mapmot/most-delta/doc/40t-5-bore.jpg

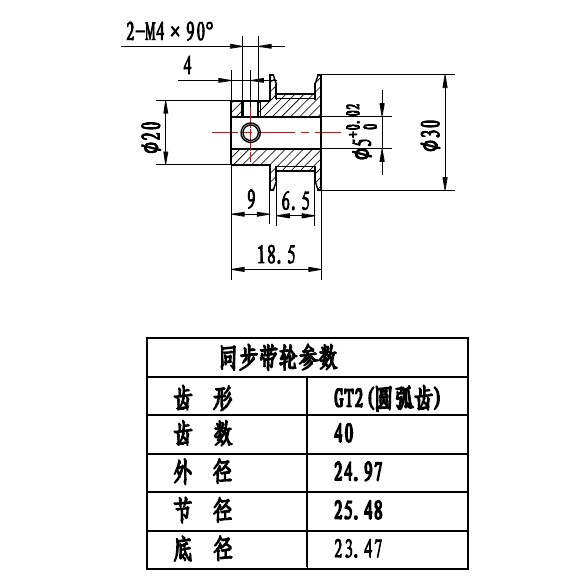
doc/40t-5-bore.jpg
