mapmot/most-delta/doc/mxl-36t-5mm.jpg

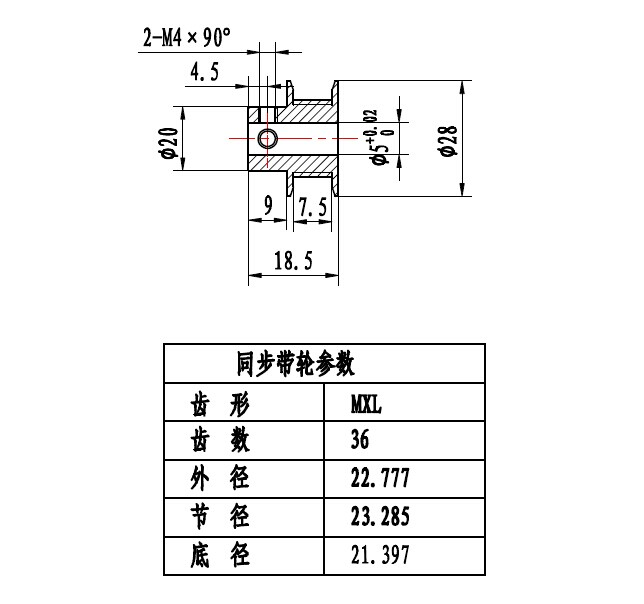
doc/mxl-36t-5mm.jpg
