mapmot/most-delta/MOST_Delta_BOM.ods

Sheet: BOM
Magnetic ball joint version
Part description | Print/Vitamin | Material | UOM | Count | Units | Total units | Functional Unit | Function
608zz bearing | Vitamin | bearing | ea | 6 |  | 6 | Apex | idler bearing
608zz bearing | Vitamin | bearing | ea | 1 |  | 1 | Extruder drive
LM8UU bearing | Vitamin | bearing | ea | 6 |  | 6 | Apex | carriage linear bearing
MR105zz 5mm x 10mm x 4mm bearing | Vitamin | bearing | ea | 1 |  | 1 | Extruder drive
3/8” od ring magnets | Vitamin | magnet | ea | 12 |  | 12 | Tie rod | tie rod ends
T5 timing belt | Vitamin | belting | mm | 3 | 1350 | 4050 | Apex | timing belt
0.25” OD x 0.222” ID Al tubing | Vitamin | Al tube | mm | 6 | 242 | 1452 | Tie rod | Tie rod
3/8” G25 ball bearings | Vitamin | magnet | mm | 12 | 20 | 240 | Tie rod | tie rod pivot
16-Gauge 2 Conductor | Vitamin | conductor | m | 1 |  | 1 | End effector | hot end power
1m twisted pair | Vitamin | conductor | m | 3 | 1 | 3 | Apex | limit switch twisted pair
1m twisted pair | Vitamin | conductor | m | 2 |  | 2 | End effector | fan power and hot end thermistor
8mm diameter drill rod | Vitamin | drill rod | mm | 6 | 595 | 3570 | Apex | guide rod
12V 5A power supply | Vitamin | electronics | ea | 1 |  | 1 | Electronics
40mm x 40mm 12v fan | Vitamin | electronics | ea | 1 |  | 1 | End effector | active cooling
Limit switch | Vitamin | electronics | ea | 3 |  | 3 | Apex | Limit switch
Melzi controller board | Vitamin | electronics | ea | 1 |  | 1 | Electronics
#6 x 3/4” sheet metal screw | Vitamin | fastener | ea | 12 |  | 12 | Apex | motor end base plate mount
#6 x 3/4” sheet metal screw | Vitamin | fastener | ea | 18 |  | 18 | Apex | motor end linking board mount
#6 x 3/4” sheet metal screw | Vitamin | fastener | ea | 12 |  | 12 | Apex | idler end base plate mount
#6 x 3/4” sheet metal screw | Vitamin | fastener | ea | 18 |  | 18 | Apex | idler end linking board mount
M2 washer | Vitamin | fastener | ea | 6 |  | 6 | Apex | limit switch mount
M2 x 12mm socket head cap screw | Vitamin | fastener | ea | 6 |  | 6 | Apex | limit switch mount
M2 x 12mm socket head cap screw | Vitamin | fastener | ea | 1 |  | 1 | End effector | hot end retainer
M3 nut | Vitamin | fastener | ea | 6 |  | 6 | Apex | motor end pulley
M3 nut | Vitamin | fastener | ea | 6 |  | 6 | Apex | motor end vertical board mount
M3 nut | Vitamin | fastener | ea | 3 |  | 3 | Apex | carriage belt terminator mount
M3 nut | Vitamin | fastener | ea | 12 |  | 12 | Apex | idler end guide rod clamp
M3 nut | Vitamin | fastener | ea | 6 |  | 6 | Apex | idler end vertical board mount
M3 nut | Vitamin | fastener | ea | 3 |  | 3 | Extruder drive
M3 nut | Vitamin | fastener | ea | 12 |  | 12 | Frame | Melzi mount
M3 nut | Vitamin | fastener | ea | 12 |  | 12 | Apex | motor end guide rod clamp
M3 threaded rod | Vitamin | fastener | mm | 6 | 85 | 510 | Apex | motor end guide rod clamp
M3 threaded rod | Vitamin | fastener | mm | 6 | 85 | 510 | Apex | idler end guide rod clamp
M3 washer | Vitamin | fastener | ea | 12 |  | 12 | Apex | motor end motor mount
M3 washer | Vitamin | fastener | ea | 12 |  | 12 | Apex | motor end guide rod clamp
M3 washer | Vitamin | fastener | ea | 6 |  | 6 | Apex | motor end vertical board mount
M3 washer | Vitamin | fastener | ea | 3 |  | 3 | Apex | carriage belt terminator mount
M3 washer | Vitamin | fastener | ea | 12 |  | 12 | Apex | idler end guide rod clamp
M3 washer | Vitamin | fastener | ea | 12 |  | 12 | Apex | idler end vertical board mount
M3 washer | Vitamin | fastener | ea | 2 |  | 2 | Extruder drive
M3 washer | Vitamin | fastener | ea | 16 |  | 16 | Frame | Melzi mount
M3 x 12mm socket head cap screw | Vitamin | fastener | ea | 2 |  | 2 | End effector | fan mount
M3 x 12mm socket head cap screw | Vitamin | fastener | ea | 3 |  | 3 | Carriage | Carriage limit switch adjustment
M3 x 14mm socket head cap screw | Vitamin | fastener | ea | 12 |  | 12 | Apex | motor end motor mount
M3 x 16mm socket head cap screw | Vitamin | fastener | ea | 3 |  | 3 | Apex | carriage belt terminator mount
M3 x 25mm socket head cap screw | Vitamin | fastener | ea | 1 |  | 1 | Extruder drive
M3 x 25mm socket head cap screw | Vitamin | fastener | ea | 4 |  | 4 | Frame | Melzi mount
M3 x 30mm socket head cap screw | Vitamin | fastener | ea | 2 |  | 2 | Extruder drive
M3 x 45mm socket head cap screw | Vitamin | fastener | ea | 2 |  | 2 | Extruder drive
M3 x 50mm screw | Vitamin | fastener | ea | 6 |  | 6 | Apex | motor end vertical board mount
M3 x 50mm screw | Vitamin | fastener | ea | 6 |  | 6 | Apex | idler end vertical board mount
M3 x 6mm button head cap screw | Vitamin | fastener | ea | 1 |  | 1 | Extruder drive
M3 x 8mm set screw | Vitamin | fastener | ea | 6 |  | 6 | Apex | motor end pulley
M4 nut | Vitamin | fastener | ea | 1 |  | 1 | End effector | Bowden sheath retainer
M4 nut | Vitamin | fastener | ea | 1 |  | 1 | Extruder drive | Infeed tube sheath retainer
M4 nut | Vitamin | fastener | ea | 1 |  | 1 | Extruder drive | Bowden sheath retainer
#6 x 1/2” sheet metal screw | Vitamin | fastener | ea | 2 |  | 2 | Extruder drive | Mounting screws
M8 nut | Vitamin | fastener | ea | 3 |  | 3 | Apex | idler shaft retainer
M8 washer | Vitamin | fastener | ea | 9 |  | 9 | Apex | idler shaft
M8 x 40mm hex head bolt | Vitamin | fastener | ea | 3 |  | 3 | Apex | idler shaft
J-head hot end, 1.75mm x 0.5mm | Vitamin | hot end | ea | 1 |  | 1 | End effector
NEMA17 stepper motor | Vitamin | motor | ea | 1 |  | 1 | Extruder drive
NEMA17 stepper motor | Vitamin | motor | ea | 3 |  | 3 | Apex | motor end motor mount
12 tooth T5 pulley w/ D shaft | Print | PLA | ea | 3 |  | 3 | Apex | pulley
Airtripper's drive body | Print | PLA | ea | 1 |  | 1 | Extruder drive
Airtripper's idler holder | Print | PLA | ea | 1 |  | 1 | Extruder drive
Airtripper's idler shaft | Print | PLA | ea | 1 |  | 1 | Extruder drive
Airtripper's tie rod | Print | PLA | ea | 1 |  | 1 | Extruder drive
carriage | Print | PLA | ea | 3 |  | 3 | Apex | carriage
Dalek_effector | Print | PLA | ea | 1 |  | 1 | End effector
end_idler | Print | PLA | ea | 3 |  | 3 | Apex | idler end
end_motor | Print | PLA | ea | 3 |  | 3 | Apex | motor end
fixed_belt_terminator | Print | PLA | ea | 3 |  | 3 | Apex | long belt terminator
free_belt_terminator | Print | PLA | ea | 3 |  | 3 | Apex | short belt terminator
340mm diameter x 12mm plywood | Vitamin | plywood | ea | 2 |  | 2 | Frame | base plates
42mm x 240mm x 12 mm plywood | Vitamin | plywood | ea | 3 |  | 3 | Apex | linking board
60mm x 605mm x 12mm plywood | Vitamin | plywood | ea | 3 |  | 3 | Apex | vertical board
1” x 1/4” rubber fuel line | Vitamin | tubing | inch | 1 | 1 | 1 | Extruder drive
4mm OD x 2mm ID PTFE tubing | Vitamin | tubing | mm | 1 | 630 | 630 | End effector | Bowden sheath
Small wire ties | Vitamin | wire tie | ea | 10 |  | 10 | Frame
Mk7 drive gear | Vitamin | drive gear | ea | 1 |  | 1 | Extruder drive

Sheet: Sources Prices
Part description | Part number | URL
M2 washer | 93475A195 | mcmaster.com
M2 x 10mm socket head cap screw | 91292A011 | mcmaster.com
M3 nut | 91828A211 | mcmaster.com
M3 nylock nut | 93625A100 | mcmaster.com
M3 threaded rod | 90024A040 | mcmaster.com
M3 washer | 93475A210 | mcmaster.com
M3 x 12mm socket head cap screw | 91292A113 | mcmaster.com
M3 x 14mm socket head cap screw | 91292A027 | mcmaster.com
M3 x 16mm socket head cap screw | 91292A115 | mcmaster.com
M3 x 25mm socket head cap screw | 91292A020 | mcmaster.com
M3 x 30mm socket head cap screw | 91292A022 | mcmaster.com
M3 x 45mm socket head cap screw | 91292A025 | mcmaster.com
M3 x 50mm screw | 91292A026 | mcmaster.com
M3 x 6mm button head cap screw | 92095A179 | mcmaster.com
M3 x 8mm set screw | 92015A105 | mcmaster.com
#6 x 3/4” sheet metal screw | 92470A151 | mcmaster.com
M4 nut | 91828A231 | mcmaster.com
#6 x 1/2” sheet metal screw | 93475A230 | mcmaster.com
M4 x 12mm socket head cap screw | 91292A117 | mcmaster.com
M4 x 20mm socket head cap screw | 91292A121 | mcmaster.com
M8 nut | 91828A410 | mcmaster.com
M8 washer | 93475A270 | mcmaster.com
M8 x 40mm hex head bolt | 91287A305 | mcmaster.com
8mm diameter drill rod | 8116K37 | mcmaster.com
4mm OD x 2mm ID PTFE tubing | 2129T24 | mcmaster.com
0.25” OD x 0.222” ID Al tubing | K&S p/n 106 | http://www.amazon.com/gp/product/B002YGKV3E/ref=oh_details_o01_s00_i00?ie=UTF8&psc=1
3/8” od ring magnets | R622CS-P | https://www.kjmagnetics.com/proddetail.asp?prod=R622CS-P
3/8” G25 ball bearings |  | http://www.amazon.com/gp/product/B002BBD4SG/ref=oh_details_o08_s00_i00?ie=UTF8&psc=1
608zz bearing |  | http://www.amazon.com/608-ZZ-Skateboard-Bearing-8x22x7-Shielded/dp/B0045F9LAG
LM8UU bearing |  | http://www.amazon.com/gp/product/B00AGCL3OO?ie=UTF8&seller=A3KVMBTSS8BMR6&sn=Sidewinderinc
MR105zz 5mm x 10mm x 4mm bearing |  | http://www.amazon.com/5x10x4MM-SEALED-BEARING-TRAXXAS-MINIATURE/dp/B00AF0STJY
T5 timing belt |  | http://shop.polybelt.com/6T5-Open-End-Belt-Roll-Polyurethane-with-Steel-Cords-B6T5-MPS.htm
16-Gauge 2 Conductor |  | http://www.amazon.com/Mediabridge-Gauge-Speaker-Wire-Feet/dp/B0044YPN0A
1/8” shock cord |  | http://www.amazon.com/SGT-KNOTS-DiamondGrip-Shock-Cord/dp/B00CA4TNX4
Limit switch | SW767-ND | http://www.digikey.com/product-detail/en/SS-3GLPT/SW767-ND/664728
12V 5A power supply |  | http://www.amazon.com/gp/product/B0023Y9EQC/ref=oh_details_o00_s01_i00?ie=UTF8&psc=1
40mm x 40mm 12v fan |  | http://www.kysanelectronics.com/Products/Detail.php?recordID=7738
Melzi controller board |  | http://www.rp3d.com/10pcs-melzi-of-3d-printer-p-20.html
NEMA17 stepper motor |  | http://www.kysanelectronics.com/Products/Detail.php?recordID=7850
J-head hot end, 1.75mm x 0.5mm |  | hotends.com
1” x 1/4” rubber fuel line |  | http://www.amazon.com/Dayco-80057-Fuel-Line-Roll/dp/B000CIZV7C
Mk7 drive gear |  | http://twelvepro.com/index.php?route=product/product&product_id=51

Sheet: Calculators
Tie Rods:
Length of rod: | 300.00 | mm
Rod ID: | 4.20 | mm
Diameter of ball bearing: | 10.32 | mm
pivot c-c: | 309.43 | mm
carbon fibre tube | 6mm/4.2mm/1.6m
carbon fibre tube | 8mm/6mm/1.6m
