mapmot/most-delta/doc/3dPRINT.xls

Sheet: BOM
Magnetic ball joint version
 |  |  |  |  |  | ЦЕНА | ОБЩО
Part description | Count | Units | Total units | Functional Unit | Function
608zz bearing | 6 |  | 6 | Apex | idler bearing |  | 0
608zz bearing | 1 |  | 1 | Extruder drive |  |  | 0
LM8UU bearing | 6 |  | 6 | Apex | carriage linear bearing |  | 156
MR105zz 5mm x 10mm x 4mm bearing | 1 |  | 1 | Extruder drive |  |  | 21.47
3/8” od ring magnets | 12 |  | 12 | Tie rod | tie rod ends |  | 40.73
T5 timing belt | 3 | 1350 | 4050 | Apex | timing belt |  | 92.1
0.25” OD x 0.222” ID Al tubing | 6 | 242 | 1452 | Tie rod | Tie rod |  | 52
3/8” G25 ball bearings | 12 | 20 | 240 | Tie rod | tie rod pivot |  | 12.3
16-Gauge 2 Conductor | 1 |  | 1 | End effector | hot end power |  | 0
1m twisted pair | 3 | 1 | 3 | Apex | limit switch twisted pair |  | 0
1m twisted pair | 2 |  | 2 | End effector | fan power and hot end thermistor |  | 0
8mm diameter drill rod | 6 | 595 | 3570 | Apex | guide rod |  | 127.67
12V 5A power supply | 1 |  | 1 | Electronics |  |  | 0
40mm x 40mm 12v fan | 1 |  | 1 | End effector | active cooling |  | 0
Limit switch | 3 |  | 3 | Apex | Limit switch |  | 0
Melzi controller board | 1 |  | 1 | Electronics |  | 90 | 90
#6 x 3/4” sheet metal screw | 12 |  | 12 | Apex | motor end base plate mount |  | 0
#6 x 3/4” sheet metal screw | 18 |  | 18 | Apex | motor end linking board mount |  | 0
#6 x 3/4” sheet metal screw | 12 |  | 12 | Apex | idler end base plate mount |  | 0
#6 x 3/4” sheet metal screw | 18 |  | 18 | Apex | idler end linking board mount |  | 0
M2 washer | 6 |  | 6 | Apex | limit switch mount |  | 0
M2 x 12mm socket head cap screw | 6 |  | 6 | Apex | limit switch mount |  | 0
M2 x 12mm socket head cap screw | 1 |  | 1 | End effector | hot end retainer |  | 0
M3 nut | 6 |  | 6 | Apex | motor end pulley |  | 0
M3 nut | 6 |  | 6 | Apex | motor end vertical board mount |  | 40
M3 nut | 3 |  | 3 | Apex | carriage belt terminator mount |  | 0
M3 nut | 12 |  | 12 | Apex | idler end guide rod clamp |  | 0
M3 nut | 6 |  | 6 | Apex | idler end vertical board mount |  | 0
M3 nut | 3 |  | 3 | Extruder drive |  |  | 0
M3 nut | 12 |  | 12 | Frame | Melzi mount |  | 0
M3 nut | 12 |  | 12 | Apex | motor end guide rod clamp |  | 0
M3 threaded rod | 6 | 85 | 510 | Apex | motor end guide rod clamp |  | 0
M3 threaded rod | 6 | 85 | 510 | Apex | idler end guide rod clamp |  | 0
M3 washer | 12 |  | 12 | Apex | motor end motor mount |  | 0
M3 washer | 12 |  | 12 | Apex | motor end guide rod clamp |  | 0
M3 washer | 6 |  | 6 | Apex | motor end vertical board mount |  | 0
M3 washer | 3 |  | 3 | Apex | carriage belt terminator mount |  | 0
M3 washer | 12 |  | 12 | Apex | idler end guide rod clamp |  | 0
M3 washer | 12 |  | 12 | Apex | idler end vertical board mount |  | 0
M3 washer | 2 |  | 2 | Extruder drive |  |  | 0
M3 washer | 16 |  | 16 | Frame | Melzi mount |  | 0
M3 x 12mm socket head cap screw | 2 |  | 2 | End effector | fan mount |  | 0
M3 x 12mm socket head cap screw | 3 |  | 3 | Carriage | Carriage limit switch adjustment |  | 0
M3 x 14mm socket head cap screw | 12 |  | 12 | Apex | motor end motor mount |  | 0
M3 x 16mm socket head cap screw | 3 |  | 3 | Apex | carriage belt terminator mount |  | 0
M3 x 25mm socket head cap screw | 1 |  | 1 | Extruder drive |  |  | 0
M3 x 25mm socket head cap screw | 4 |  | 4 | Frame | Melzi mount |  | 0
M3 x 30mm socket head cap screw | 2 |  | 2 | Extruder drive |  |  | 0
M3 x 45mm socket head cap screw | 2 |  | 2 | Extruder drive |  |  | 0
M3 x 50mm screw | 6 |  | 6 | Apex | motor end vertical board mount |  | 0
M3 x 50mm screw | 6 |  | 6 | Apex | idler end vertical board mount |  | 0
M3 x 6mm button head cap screw | 1 |  | 1 | Extruder drive |  |  | 0
M3 x 8mm set screw | 6 |  | 6 | Apex | motor end pulley |  | 0
M4 nut | 1 |  | 1 | End effector | Bowden sheath retainer |  | 0
M4 nut | 1 |  | 1 | Extruder drive | Infeed tube sheath retainer |  | 0
M4 nut | 1 |  | 1 | Extruder drive | Bowden sheath retainer |  | 0
#6 x 1/2” sheet metal screw | 2 |  | 2 | Extruder drive | Mounting screws |  | 0
M8 nut | 3 |  | 3 | Apex | idler shaft retainer |  | 0
M8 washer | 9 |  | 9 | Apex | idler shaft |  | 0
M8 x 40mm hex head bolt | 3 |  | 3 | Apex | idler shaft |  | 0
J-head hot end, 1.75mm x 0.5mm | 1 |  | 1 | End effector |  | 164.29 | 164.29
NEMA17 stepper motor | 1 |  | 1 | Extruder drive |  | 59.51 | 59.51
NEMA17 stepper motor | 3 |  | 3 | Apex | motor end motor mount | 59.51 | 178.53
12 tooth T5 pulley w/ D shaft | 3 |  | 3 | Apex | pulley | 0 | 0
Airtripper's drive body | 1 |  | 1 | Extruder drive |  | 200 | 200
Airtripper's idler holder | 1 |  | 1 | Extruder drive |  | 0 | 0
Airtripper's idler shaft | 1 |  | 1 | Extruder drive |  | 0 | 0
Airtripper's tie rod | 1 |  | 1 | Extruder drive |  | 0 | 0
carriage | 3 |  | 3 | Apex | carriage | 0 | 0
Dalek_effector | 1 |  | 1 | End effector |  | 0 | 0
end_idler | 3 |  | 3 | Apex | idler end | 0 | 0
end_motor | 3 |  | 3 | Apex | motor end | 0 | 0
fixed_belt_terminator | 3 |  | 3 | Apex | long belt terminator | 0 | 0
free_belt_terminator | 3 |  | 3 | Apex | short belt terminator | 0 | 0
394mm diameter x 12mm plywood | 2 |  | 2 | Frame | base plates |  | 0
42mm x 280mm x 12 mm plywood | 3 |  | 3 | Apex | linking board |  | 0
70mm x 605mm x 12mm plywood | 3 |  | 3 | Apex | vertical board |  | 21
1” x 1/4” rubber fuel line | 1 | 1 | 1 | Extruder drive |  |  | 0
4mm OD x 2mm ID PTFE tubing | 1 | 630 | 630 | End effector | Bowden sheath |  | 0
Small wire ties | 10 |  | 10 | Frame |  |  | 0
Mk7 drive gear | 1 |  | 1 | Extruder drive |  | 54.44 | 54.44
 |  |  |  |  |  |  | 0
 |  |  |  |  |  |  | 1310.04

Sheet: Sources Prices
Part description | Part number | URL
M2 washer | 93475A195 | mcmaster.com | DIN 125 | 6
M2 x 10mm socket head cap screw | 91292A011 | mcmaster.com | DIN 912 | 7
M3 nylock nut | 93625A100 | mcmaster.com | DIN 985 | 60
M3 threaded rod | 90024A040 | mcmaster.com | DIN 975 | 12x85mm
M3 washer | 93475A210 | mcmaster.com | DIN 125 | 75
M3 x 12mm socket head cap screw | 91292A113 | mcmaster.com | DIN 912-A2 | 5
M3 x 14mm socket head cap screw | 91292A027 | mcmaster.com | DIN 912-A2 | 12
M3 x 16mm socket head cap screw | 91292A115 | mcmaster.com | DIN 912-A2 | 3
M3 x 25mm socket head cap screw | 91292A020 | mcmaster.com | DIN 912-A2 | 5
M3 x 30mm socket head cap screw | 91292A022 | mcmaster.com | DIN 912-A2 | 2
M3 x 45mm socket head cap screw | 91292A025 | mcmaster.com | DIN 912-A2 | 2
M3 x 50mm screw | 91292A026 | mcmaster.com | DIN 912-A2 | 12
M3 x 6mm button head cap screw | 92095A179 | mcmaster.com |  | 1
M3 x 8mm set screw | 92015A105 | mcmaster.com | DIN 916/ISO 4029 | 6
M2.9 x 19mm sheet metal screw | 92470A151 | mcmaster.com | DIN 7981 | 60
M4 nut | 91828A231 | mcmaster.com | DIN 934 / ISO 4032 | 3
M2.9 x 13mm sheet metal screw | 93475A230 | mcmaster.com | DIN 7981 | 2
M4 x 12mm socket head cap screw | 91292A117 | mcmaster.com | DIN 912-A2 | 3
M4 x 20mm socket head cap screw | 91292A121 | mcmaster.com | DIN 912-A2 | 3
M8 nut | 91828A410 | mcmaster.com | DIN 934 | 3
M8 washer | 93475A270 | mcmaster.com | DIN 125 | 9
M8 x 40mm hex head bolt | 91287A305 | mcmaster.com | DIN 933-A4 | 3
8mm diameter drill rod | 8116K37 | mcmaster.com
4mm OD x 2mm ID PTFE tubing | 2129T24 | mcmaster.com
0.25” OD x 0.222” ID Al tubing | K&S p/n 106 | http://www.amazon.com/gp/product/B002YGKV3E/ref=oh_details_o01_s00_i00?ie=UTF8&psc=1
3/8” od ring magnets | R622CS-P | https://www.kjmagnetics.com/proddetail.asp?prod=R622CS-P
3/8” G25 ball bearings |  | http://www.amazon.com/gp/product/B002BBD4SG/ref=oh_details_o08_s00_i00?ie=UTF8&psc=1
608zz bearing |  | http://www.amazon.com/608-ZZ-Skateboard-Bearing-8x22x7-Shielded/dp/B0045F9LAG
LM8UU bearing |  | http://www.amazon.com/gp/product/B00AGCL3OO?ie=UTF8&seller=A3KVMBTSS8BMR6&sn=Sidewinderinc
MR105zz 5mm x 10mm x 4mm bearing |  | http://www.amazon.com/5x10x4MM-SEALED-BEARING-TRAXXAS-MINIATURE/dp/B00AF0STJY
T5 timing belt |  | http://shop.polybelt.com/6T5-Open-End-Belt-Roll-Polyurethane-with-Steel-Cords-B6T5-MPS.htm
16-Gauge 2 Conductor |  | http://www.amazon.com/Mediabridge-Gauge-Speaker-Wire-Feet/dp/B0044YPN0A
1/8” shock cord |  | http://www.amazon.com/SGT-KNOTS-DiamondGrip-Shock-Cord/dp/B00CA4TNX4
Limit switch | SW767-ND | http://www.digikey.com/product-detail/en/SS-3GLPT/SW767-ND/664728
12V 5A power supply |  | http://www.amazon.com/gp/product/B0023Y9EQC/ref=oh_details_o00_s01_i00?ie=UTF8&psc=1
40mm x 40mm 12v fan |  | http://www.kysanelectronics.com/Products/Detail.php?recordID=7738
Melzi controller board |  | http://www.rp3d.com/10pcs-melzi-of-3d-printer-p-20.html
NEMA17 stepper motor
J-head hot end, 1.75mm x 0.5mm |  | hotends.com
1” x 1/4” rubber fuel line |  | http://www.amazon.com/Dayco-80057-Fuel-Line-Roll/dp/B000CIZV7C
Mk7 drive gear |  | http://twelvepro.com/index.php?route=product/product&product_id=51

Sheet: Calculators
 |  |  |  | spiderbot | orion delta | ultimaker | makerbot | cube | DAVID
 |  |  | точност |  | 0.05 | ,02мм | 0.1
Tie Rods: |  |  | обем на печат | 18/18 | 15/23 | 23/22,5/20,5 | 25/20/15
Length of rod: | 300.00 | mm | скорост на печат |  | до 300мм/сек | 30-300мм/сек
Rod ID: | 4.00 | mm | диаметър на материала | 1.75 |  | 2,85мм | 1.75
Diameter of ball bearing: | 10.32 | mm | диаметър на дюзата |  | ,5мм | ,4мм | ,4мм
pivot c-c: | 309.51 | mm | раб. Т. На дюзата |  |  | 180-260 С
 |  |  | ЦЕНА | 2550 | 2061 | 3800/2000 | 3450 |  | 4640
 |  |  | 1кг = 765см3 | 64лв | ,08ст/см3
 |  |  | 26см3 - 2 ч
 |  |  | 3 х 2ч = 6ч
 |  |  | 26см3 х 3 = 78см3/ден
 |  |  | 78см3/ден х ,80лв = 62лв/ден
 |  |  | 78см3 х ,08ст = 6лв р-д м-л
 |  |  | 56лв ДНЕВНО Х 20 =1120лв
