mapmot/most-delta/STL/clamp.stl

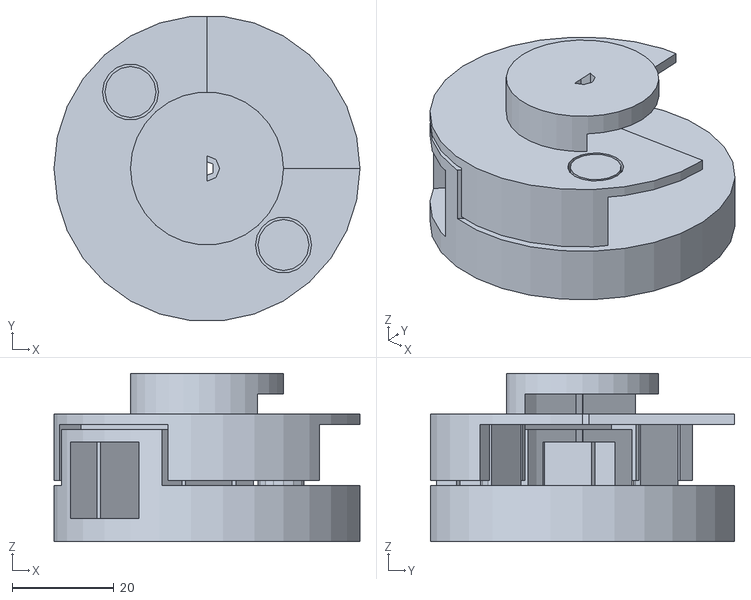
[picture p3: CAD file, 2014-09-01]
STL/clamp.stl
60.0 x 59.7 x 33.0
