mapmot/most-delta/STL/extdrive.stl

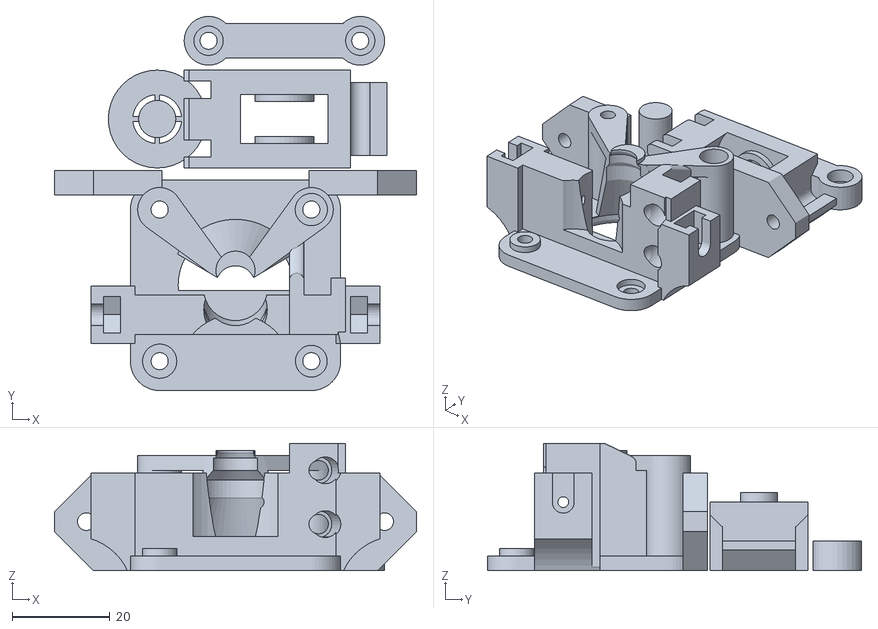
[picture p4: CAD file, 2014-09-01]
STL/extdrive.stl
74.0 x 76.5 x 26.0
