mapmot/most-delta/STL/end_motor.stl

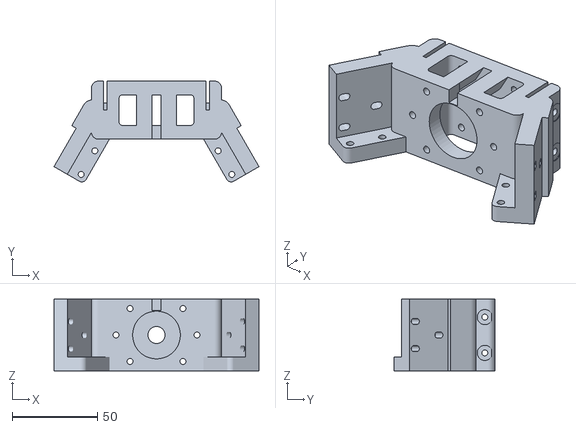
[picture p5: CAD file, 2014-07-18]
STL/end_motor.stl
120.2 x 59.1 x 42.0
