mapmot/most-delta/STL/end_idler.stl

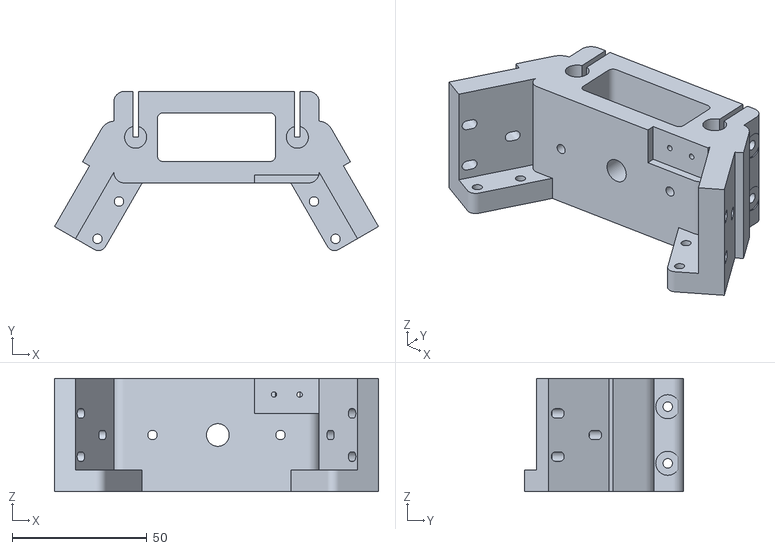
[picture p6: CAD file, 2014-07-18]
STL/end_idler.stl
120.2 x 59.1 x 42.0
