mapmot/most-delta/STL/carriage.stl

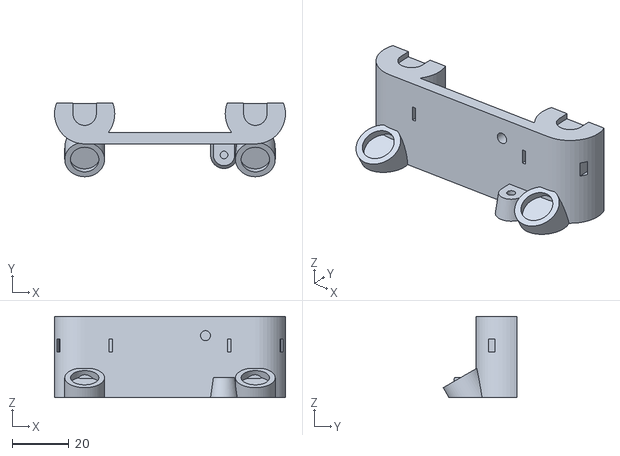
[picture p7: CAD file, 2014-06-17]
STL/carriage.stl
81.2 x 25.9 x 28.5
