mapmot/most-delta/STL/linking_brd_template.stl

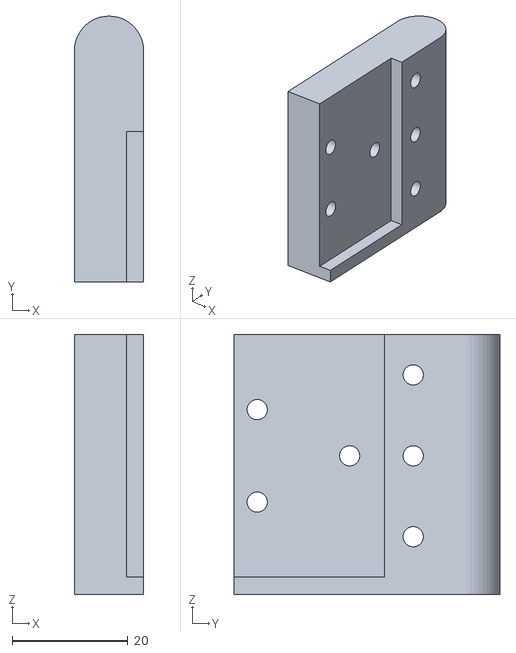
[picture p8: CAD file, 2014-06-17]
STL/linking_brd_template.stl
12.0 x 46.0 x 45.0
