mapmot/most-delta/STL/effector.stl

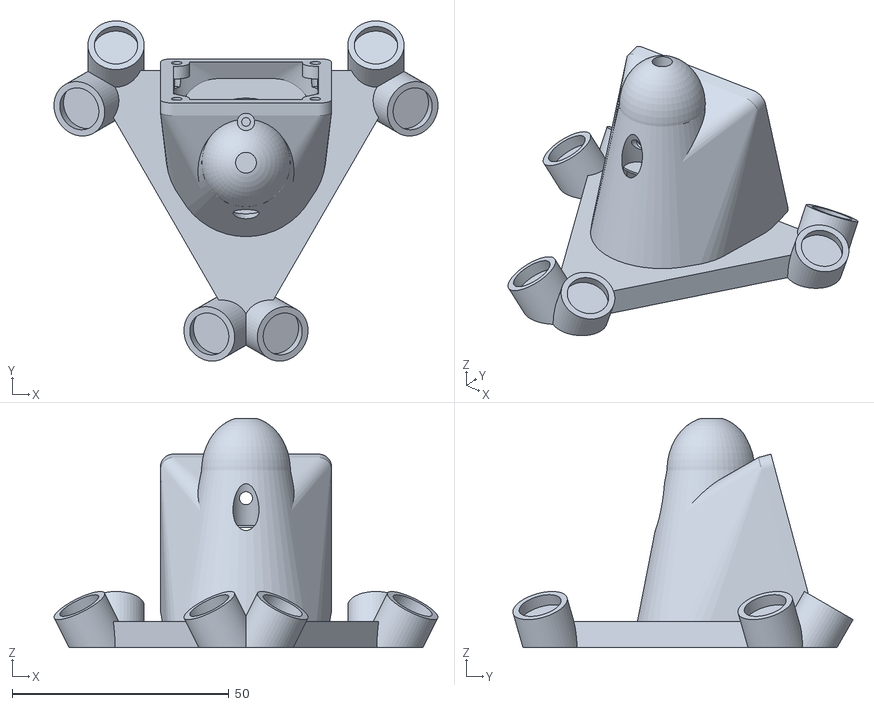
[picture p9: CAD file, 2014-06-17]
STL/effector.stl
88.6 x 78.6 x 52.9
