mapmot/most-delta/SCAD/belt_profiles.scad

/**********

	This is public Domain Code
	By: Chowderhead
	On or about: July, 2012

	Belt profile library in my fondest dreams would encapsulate profile data for all of the popular timing belt
	profiles that people like to use for their robotics projects. Please contribute your tested profiles!
	
	definitions:
		p = pitch; "The distance between successive corresponding points or lines, e.g., between the teeth of a cogwheel"
		hs = total belt height from belt back to tooth tip
		ht = total height of tooth from belt root line to tooth tip
		s = tooth root width; distance between root radii centers
		g = tooth flank angle; if tooth flanks were extended until they intercepted, this is the angle they'd make
		ra = tooth tip radius connecting tooth flank to tooth tip
		rr = tooth root radius connecting tooth flank to belt root line
		w_scale = tooth width scale. Increase or decrease to improve tooth fit
		h_scale = tooth height scale. Increase or decrease to improve tooth fit

**********/

//belt profile for T5 timing belt
T5 = [
	5, // p, pitch (mm) -- 0
	2.2, // hs, total belt height (mm) -- 1
	1.2, // ht, tooth height (mm) -- 2
	2.65, // s, tooth root width (mm) -- 3
	40, // g, tooth flank angle (deg) -- 4
	0.4, // ra, tip radius connecting tooth flank to tooth tip (mm) -- 5
	0.4, // rr, root radius connecting tooth flank to belt root line (mm) -- 6
	1.3, // w_scale, factor applied to scale tooth width -- 7
	1.3 // h_scale, factor applied to scale tooth height -- 8
];

//belt profile for T2.5 timing belt
T2_5 = [
	2.5,
	1.3,
	0.7,
	1.5,
	40,
	0.2,
	0.2,
	1.3,
	1.3
];

GT2 = [
	2, // p, pitch (mm) -- 0
	1.38, // hs, total belt height (mm) -- 1
	0.75, // ht, tooth height (mm) -- 2
	2, // s, tooth root width (mm) -- 3
	100, // g, tooth flank angle (deg) -- 4
	0.555, // ra, tip radius connecting tooth flank to tooth tip (mm) -- 5
	1, // rr, root radius connecting tooth flank to belt root line (mm) -- 6
	1.3, // w_scale, factor applied to scale tooth width -- 7
	1.3 // h_scale, factor applied to scale tooth height -- 8
];
