mapmot/most-delta/(list of files, cad)

Other CAD files:
STL/b.stl
