mapmot/most-delta/Repetier/Configuration.h

#define CONFIGURATION_H
#define NUM_EXTRUDER 1
#define MOTHERBOARD 63
#include "pins.h"
#define DRIVE_SYSTEM 3
#if DRIVE_SYSTEM==3
#define DELTA_DRIVE_TYPE 0
#if DELTA_DRIVE_TYPE == 0
#define BELT_PITCH 2
#define PULLEY_TEETH 40
#define PULLEY_CIRCUMFERENCE (BELT_PITCH * PULLEY_TEETH)
#elif DELTA_DRIVE_TYPE == 1
#define PULLEY_DIAMETER 10
#define PULLEY_CIRCUMFERENCE (PULLEY_DIAMETER * 3.1415927)
#endif
#define STEPS_PER_ROTATION 200
#define MICRO_STEPS 16
#define AXIS_STEPS_PER_MM ((float)(MICRO_STEPS * STEPS_PER_ROTATION) / PULLEY_CIRCUMFERENCE)
#define XAXIS_STEPS_PER_MM AXIS_STEPS_PER_MM
#define YAXIS_STEPS_PER_MM AXIS_STEPS_PER_MM
#define ZAXIS_STEPS_PER_MM AXIS_STEPS_PER_MM
#else
#define XAXIS_STEPS_PER_MM 98.425196
#define YAXIS_STEPS_PER_MM 98.425196
#define ZAXIS_STEPS_PER_MM 2560
#endif
#define EXTRUDER_FAN_COOL_TEMP 50
#define EXT0_X_OFFSET 0
#define EXT0_Y_OFFSET 0
#define EXT0_STEPS_PER_MM 92
#define EXT0_TEMPSENSOR_TYPE 8
#define EXT0_TEMPSENSOR_PIN TEMP_0_PIN
#define EXT0_HEATER_PIN HEATER_0_PIN
#define EXT0_STEP_PIN E0_STEP_PIN
#define EXT0_DIR_PIN E0_DIR_PIN
#define EXT0_INVERSE true
#define EXT0_ENABLE_PIN E0_ENABLE_PIN
#define EXT0_ENABLE_ON false
#define EXT0_MAX_FEEDRATE 30
#define EXT0_MAX_START_FEEDRATE 10
#define EXT0_MAX_ACCELERATION 4000
#define EXT0_HEAT_MANAGER 1
#define EXT0_WATCHPERIOD 1
#define EXT0_PID_INTEGRAL_DRIVE_MAX 140
#define EXT0_PID_INTEGRAL_DRIVE_MIN 60
#define EXT0_PID_P   4.91
#define EXT0_PID_I   0.58
#define EXT0_PID_D 10.41
#define EXT0_PID_MAX 255
#define EXT0_ADVANCE_K 0.0f
#define EXT0_ADVANCE_L 0.0f
#define EXT0_ADVANCE_BACKLASH_STEPS 0
#define EXT0_WAIT_RETRACT_TEMP 		150
#define EXT0_WAIT_RETRACT_UNITS 	0
#define EXT0_SELECT_COMMANDS "M117 Extruder 1"
#define EXT0_DESELECT_COMMANDS ""
#define EXT0_EXTRUDER_COOLER_PIN -1
#define EXT0_EXTRUDER_COOLER_SPEED 255
#define RETRACT_DURING_HEATUP false
#define PID_CONTROL_RANGE 20
#define EXTRUDE_MAXLENGTH 100
#define SKIP_M109_IF_WITHIN 2
#define SCALE_PID_TO_MAX 0
#define NUM_TEMPS_USERTHERMISTOR0 28
#define USER_THERMISTORTABLE0  {\
  {1*4,864*8},{21*4,300*8},{25*4,290*8},{29*4,280*8},{33*4,270*8},{39*4,260*8},{46*4,250*8},{54*4,240*8},{64*4,230*8},{75*4,220*8},\
  {90*4,210*8},{107*4,200*8},{128*4,190*8},{154*4,180*8},{184*4,170*8},{221*4,160*8},{265*4,150*8},{316*4,140*8},{375*4,130*8},\
  {441*4,120*8},{513*4,110*8},{588*4,100*8},{734*4,80*8},{856*4,60*8},{938*4,40*8},{986*4,20*8},{1008*4,0*8},{1018*4,-20*8}	}
#define NUM_TEMPS_USERTHERMISTOR1 0
#define USER_THERMISTORTABLE1  {}
#define NUM_TEMPS_USERTHERMISTOR2 0
#define USER_THERMISTORTABLE2  {}
#define USE_GENERIC_THERMISTORTABLE_1
#define GENERIC_THERM1_T0 25
#define GENERIC_THERM1_R0 100000
#define GENERIC_THERM1_BETA 3887
#define GENERIC_THERM1_MIN_TEMP -60
#define GENERIC_THERM1_MAX_TEMP 300
#define GENERIC_THERM1_R1 0
#define GENERIC_THERM1_R2 10000
#define GENERIC_THERM2_T0 170
#define GENERIC_THERM2_R0 1042.7
#define GENERIC_THERM2_BETA 4036
#define GENERIC_THERM2_MIN_TEMP -20
#define GENERIC_THERM2_MAX_TEMP 300
#define GENERIC_THERM2_R1 0
#define GENERIC_THERM2_R2 4700
#define GENERIC_THERM3_T0 170
#define GENERIC_THERM3_R0 1042.7
#define GENERIC_THERM3_BETA 4036
#define GENERIC_THERM3_MIN_TEMP -20
#define GENERIC_THERM3_MAX_TEMP 300
#define GENERIC_THERM3_R1 0
#define GENERIC_THERM3_R2 4700
#define GENERIC_THERM_VREF 5
#define GENERIC_THERM_NUM_ENTRIES 33
#define HAVE_HEATED_BED true
#define HEATED_BED_MAX_TEMP 150
#define SKIP_M190_IF_WITHIN 10
#define HEATED_BED_SENSOR_TYPE 1
#define HEATED_BED_SENSOR_PIN TEMP_1_PIN
#define HEATED_BED_HEATER_PIN HEATER_1_PIN
#define HEATED_BED_SET_INTERVAL 5000
#define HEATED_BED_HEAT_MANAGER 2
#define HEATED_BED_PID_INTEGRAL_DRIVE_MAX 255
#define HEATED_BED_PID_INTEGRAL_DRIVE_MIN 80
#define HEATED_BED_PID_PGAIN   196
#define HEATED_BED_PID_IGAIN   33.02
#define HEATED_BED_PID_DGAIN 290
#define HEATED_BED_PID_MAX 255
#define MAXTEMP 285
#define MIN_DEFECT_TEMPERATURE -10
#define MAX_DEFECT_TEMPERATURE 300
#define ENDSTOP_PULLUP_X_MIN false
#define ENDSTOP_PULLUP_Y_MIN false
#define ENDSTOP_PULLUP_Z_MIN false
#define ENDSTOP_PULLUP_X_MAX true
#define ENDSTOP_PULLUP_Y_MAX true
#define ENDSTOP_PULLUP_Z_MAX true
#define ENDSTOP_X_MIN_INVERTING false
#define ENDSTOP_Y_MIN_INVERTING false
#define ENDSTOP_Z_MIN_INVERTING false
#define ENDSTOP_X_MAX_INVERTING false
#define ENDSTOP_Y_MAX_INVERTING false
#define ENDSTOP_Z_MAX_INVERTING false
#define MIN_HARDWARE_ENDSTOP_X false
#define MIN_HARDWARE_ENDSTOP_Y false
#define MIN_HARDWARE_ENDSTOP_Z false
#define MAX_HARDWARE_ENDSTOP_X true
#define MAX_HARDWARE_ENDSTOP_Y true
#define MAX_HARDWARE_ENDSTOP_Z true
#define X_ENABLE_ON 0
#define Y_ENABLE_ON 0
#define Z_ENABLE_ON 0
#define DISABLE_X false
#define DISABLE_Y false
#define DISABLE_Z false
#define DISABLE_E false
#define INVERT_X_DIR true
#define INVERT_Y_DIR true
#define INVERT_Z_DIR true
#define X_HOME_DIR 1
#define Y_HOME_DIR 1
#define Z_HOME_DIR 1
#define max_software_endstop_r true
#define min_software_endstop_x false
#define min_software_endstop_y false
#define min_software_endstop_z false
#define max_software_endstop_x false
#define max_software_endstop_y false
#define max_software_endstop_z false
#define ENDSTOP_X_BACK_MOVE 5
#define ENDSTOP_Y_BACK_MOVE 5
#define ENDSTOP_Z_BACK_MOVE 5
#define ENDSTOP_X_RETEST_REDUCTION_FACTOR 8
#define ENDSTOP_Y_RETEST_REDUCTION_FACTOR 8
#define ENDSTOP_Z_RETEST_REDUCTION_FACTOR 8
#define ENDSTOP_X_BACK_ON_HOME 0
#define ENDSTOP_Y_BACK_ON_HOME 0
#define ENDSTOP_Z_BACK_ON_HOME 0
#define ALWAYS_CHECK_ENDSTOPS true
#define X_MAX_LENGTH 200
#define Y_MAX_LENGTH 200
#define Z_MAX_LENGTH 147
#define X_MIN_POS 0
#define Y_MIN_POS 0
#define Z_MIN_POS 0
#define MICROSTEP_MODES {8,8,8,8,8} // [1,2,4,8,16]
#if MOTHERBOARD==301
#define MOTOR_CURRENT {135,135,135,135,135} // Values 0-255 (RAMBO 135 = ~0.75A, 185 = ~1A)
#elif MOTHERBOARD==12
#define MOTOR_CURRENT {35713,35713,35713,35713,35713} // Values 0-65535 (3D Master 35713 = ~1A)
#endif
#define DELTA_SEGMENTS_PER_SECOND_PRINT 180 // Move accurate setting for print moves
#define DELTA_SEGMENTS_PER_SECOND_MOVE 70 // Less accurate setting for other moves
#if DRIVE_SYSTEM==3
#define DELTA_DIAGONAL_ROD 344.13 // mm
#define DELTA_ALPHA_A 210
#define DELTA_ALPHA_B 330
#define DELTA_ALPHA_C 90
#define DELTA_RADIUS_CORRECTION_A 0
#define DELTA_RADIUS_CORRECTION_B 0
#define DELTA_RADIUS_CORRECTION_C 0
#define DELTA_DIAGONAL_CORRECTION_A 0
#define DELTA_DIAGONAL_CORRECTION_B 0
#define DELTA_DIAGONAL_CORRECTION_C 0
#define DELTA_MAX_RADIUS 150
#define END_EFFECTOR_HORIZONTAL_OFFSET 29
#define CARRIAGE_HORIZONTAL_OFFSET 18
#define PRINTER_RADIUS 218.861
#define DELTA_RADIUS (PRINTER_RADIUS-END_EFFECTOR_HORIZONTAL_OFFSET-CARRIAGE_HORIZONTAL_OFFSET)
#define DELTA_HOME_ON_POWER false
#define DELTA_X_ENDSTOP_OFFSET_STEPS 0
#define DELTA_Y_ENDSTOP_OFFSET_STEPS 0
#define DELTA_Z_ENDSTOP_OFFSET_STEPS 0
#define SOFTWARE_LEVELING
#endif
#define MAX_DELTA_SEGMENTS_PER_LINE 22
#define STEPPER_INACTIVE_TIME 360
#define MAX_INACTIVE_TIME 0L
#define MAX_FEEDRATE_X 2000
#define MAX_FEEDRATE_Y 2000
#define MAX_FEEDRATE_Z 2000
#define HOMING_FEEDRATE_X 100
#define HOMING_FEEDRATE_Y 100
#define HOMING_FEEDRATE_Z 100
#define HOMING_ORDER HOME_ORDER_ZXY
#define ENABLE_BACKLASH_COMPENSATION false
#define Z_BACKLASH 0
#define X_BACKLASH 0
#define Y_BACKLASH 0
#define RAMP_ACCELERATION 1
#define STEPPER_HIGH_DELAY 0
#define STEP_DOUBLER_FREQUENCY 12000
#define ALLOW_QUADSTEPPING true
#define DOUBLE_STEP_DELAY 1 // time in microseconds
#define MAX_HALFSTEP_INTERVAL 1999
#define MAX_ACCELERATION_UNITS_PER_SQ_SECOND_X 3000
#define MAX_ACCELERATION_UNITS_PER_SQ_SECOND_Y 3000
#define MAX_ACCELERATION_UNITS_PER_SQ_SECOND_Z 3000
#define MAX_TRAVEL_ACCELERATION_UNITS_PER_SQ_SECOND_X 5000
#define MAX_TRAVEL_ACCELERATION_UNITS_PER_SQ_SECOND_Y 5000
#define MAX_TRAVEL_ACCELERATION_UNITS_PER_SQ_SECOND_Z 5000
#define MAX_JERK 20.0
#define MAX_ZJERK 0.3
#define MOVE_CACHE_SIZE 16
#define MOVE_CACHE_LOW 10
#define LOW_TICKS_PER_MOVE 250000
#define MIN_EXTRUDER_TEMP 0
#define USE_ADVANCE
#define ENABLE_QUADRATIC_ADVANCE
#define BAUDRATE 115200
#define ENABLE_POWER_ON_STARTUP
#define POWER_INVERTING false
#define KILL_METHOD 1
#define GCODE_BUFFER_SIZE 2
#define ACK_WITH_LINENUMBER
#define WAITING_IDENTIFIER "wait"
#define ECHO_ON_EXECUTE
#define EEPROM_MODE 1
#define FEATURE_TWO_XSTEPPER false
#define X2_STEP_PIN   E1_STEP_PIN
#define X2_DIR_PIN    E1_DIR_PIN
#define X2_ENABLE_PIN E1_ENABLE_PIN
#define FEATURE_TWO_YSTEPPER false
#define Y2_STEP_PIN   E1_STEP_PIN
#define Y2_DIR_PIN    E1_DIR_PIN
#define Y2_ENABLE_PIN E1_ENABLE_PIN
#define FEATURE_TWO_ZSTEPPER false
#define Z2_STEP_PIN   E1_STEP_PIN
#define Z2_DIR_PIN    E1_DIR_PIN
#define Z2_ENABLE_PIN E1_ENABLE_PIN
#define FEATURE_DITTO_PRINTING false
#define FEATURE_SERVO false
#define SERVO0_PIN 11
#define SERVO1_PIN 6
#define SERVO2_PIN 5
#define SERVO3_PIN 4
#define FEATURE_WATCHDOG true
#define FEATURE_Z_PROBE false
#define Z_PROBE_PIN 63
#define Z_PROBE_PULLUP true
#define Z_PROBE_ON_HIGH true
#define Z_PROBE_X_OFFSET 0
#define Z_PROBE_Y_OFFSET 0
#define Z_PROBE_BED_DISTANCE 5.0 // Higher than max bed level distance error in mm
#define Z_PROBE_WAIT_BEFORE_TEST true
#define Z_PROBE_SPEED 2
#define Z_PROBE_XY_SPEED 150
#define Z_PROBE_SWITCHING_DISTANCE 1.5 // Distance to safely switch off probe
#define Z_PROBE_REPETITIONS 5 // Repetitions for probing at one point.
#define Z_PROBE_HEIGHT 39.91
#define Z_PROBE_START_SCRIPT ""
#define Z_PROBE_FINISHED_SCRIPT ""
#define FEATURE_AUTOLEVEL false
#define Z_PROBE_X1 100
#define Z_PROBE_Y1 20
#define Z_PROBE_X2 160
#define Z_PROBE_Y2 170
#define Z_PROBE_X3 20
#define Z_PROBE_Y3 170
#define FEATURE_BABYSTEPPING 0
#define BABYSTEP_MULTIPLICATOR 1
#define CASE_LIGHTS_PIN -1
#define CASE_LIGHT_DEFAULT_ON 1
#define SDSUPPORT true
#define SDCARDDETECT -1
#define SDCARDDETECTINVERTED false
#define SD_EXTENDED_DIR false
#define ARC_SUPPORT true
#define FEATURE_MEMORY_POSITION true
#define FEATURE_CHECKSUM_FORCED false
#define FEATURE_FAN_CONTROL true
#define FEATURE_CONTROLLER 0
#define UI_LANGUAGE 1
#define UI_PRINTER_NAME ""
#define UI_PRINTER_COMPANY ""
#define UI_ANIMATION true
#define UI_PAGES_DURATION 4000
#define UI_START_SCREEN_DELAY 1000
#define UI_DISABLE_AUTO_PAGESWITCH true
#define UI_AUTORETURN_TO_MENU_AFTER 30000
#define FEATURE_UI_KEYS 0
#define UI_ENCODER_SPEED 1
#define UI_SPEEDDEPENDENT_POSITIONING true
#define UI_KEY_BOUNCETIME 10
#define UI_KEY_FIRST_REPEAT 500
#define UI_KEY_REDUCE_REPEAT 50
#define UI_KEY_MIN_REPEAT 50
#define FEATURE_BEEPER false
#define BEEPER_SHORT_SEQUENCE 2,2
#define BEEPER_LONG_SEQUENCE 8,8
#define UI_SET_PRESET_HEATED_BED_TEMP_PLA 60
#define UI_SET_PRESET_EXTRUDER_TEMP_PLA   180
#define UI_SET_PRESET_HEATED_BED_TEMP_ABS 110
#define UI_SET_PRESET_EXTRUDER_TEMP_ABS   240
#define UI_SET_MIN_HEATED_BED_TEMP  55
#define UI_SET_MAX_HEATED_BED_TEMP 120
#define UI_SET_MIN_EXTRUDER_TEMP   160
#define UI_SET_MAX_EXTRUDER_TEMP   270
#define UI_SET_EXTRUDER_FEEDRATE 2 // mm/sec
#define UI_SET_EXTRUDER_RETRACT_DISTANCE 3 // mm
