mapmot/most-delta/(commit log)

2014-06-12 Initial design
    [simple_delta.scad]
2014-06-17 Pre-production version
    [carriage.stl, effector.stl, end_idler.stl, end_motor.stl, linking_brd_template.stl, parametric_belt.scad, parametric_pulley.scad, simple_delta.scad]
